stupidityisavirtue/ODT2026-The-Wanderer/Electronics Details/Circuit Diagrams/Manual Servo Circuit Diagram.jpeg

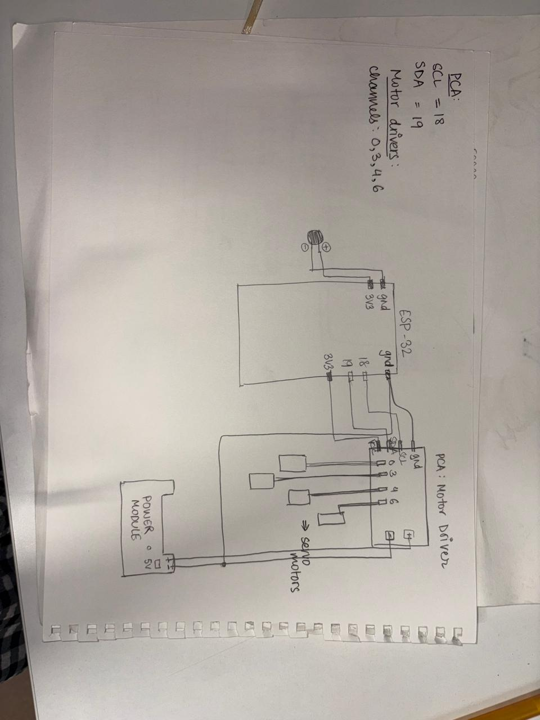
Electronics Details/Circuit Diagrams/Manual Servo Circuit Diagram.jpeg
