stupidityisavirtue/ODT2026-The-Wanderer/Electronics Details/Circuit Diagrams/Manual Console Diagram.jpeg

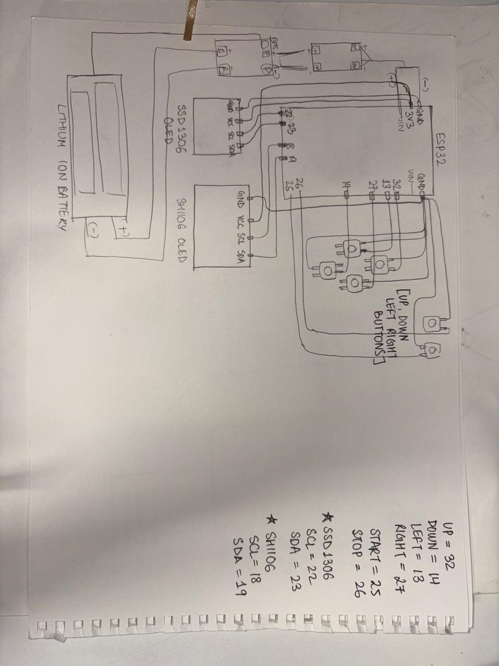
Electronics Details/Circuit Diagrams/Manual Console Diagram.jpeg
