stupidityisavirtue/ODT2026-The-Wanderer/Electronics Details/Electronic_Details_filled BY Manasa.docx

Electronics Documentation

Wanderer — A Dancing Doll Console Game

Manasa | Section C | 2025014044

# 1. Electronics Block Diagram

Wanderer consists of two physically separate ESP32 systems communicating wirelessly via ESP-NOW. The diagram below describes the signal and power flow across both units.

## Signal & Power Flow

- Console ESP32 → I2C0 (SCL=18, SDA=19) → SH1106 OLED (game display)
- Console ESP32 → I2C1 (SCL=22, SDA=23) → SSD1306 OLED (animation display)
- Console ESP32 → GPIO 27/14/32/13/25/26 → 6 tactile buttons (active-low, PULL_UP)
- Console ESP32 → ESP-NOW (Wi-Fi radio) → Stage ESP32 (UP/DOWN/LEFT/RIGHT commands)
- Stage ESP32 → I2C (addr 0x40) → PCA9685 PWM Driver
- PCA9685 → PWM channels 0, 3, 4, 6 → 4 Servo Motors (doll limbs)
- 18650 × 2 → 5V Power Module → Stage ESP32 + PCA9685 + Servos

## Console ESP32 — Pin Map

Component | Pin / Bus | Configuration
SH1106 OLED (game) | SCL = GPIO 18, SDA = GPIO 19 | I2C0
SSD1306 OLED (anim) | SCL = GPIO 22, SDA = GPIO 23 | I2C1
RIGHT button | GPIO 27 | PULL_UP, active low
DOWN button | GPIO 14 | PULL_UP, active low
UP button | GPIO 32 | PULL_UP, active low
LEFT button | GPIO 13 | PULL_UP, active low
START button | GPIO 25 | PULL_UP, active low
STOP button | GPIO 26 | PULL_UP, active low

## Stage ESP32 — Pin Map

Component | Channel / Pin | Notes
PCA9685 PWM Driver | I2C addr 0x40, SCL/SDA | Controls all 4 servos
Servo — UP (right arm) | PCA9685 Channel 0 | Neutral = 65°, duty range 500–1800µs
Servo — DOWN (right leg) | PCA9685 Channel 3 | Neutral = 65°, duty range 500–1800µs
Servo — LEFT (left arm) | PCA9685 Channel 4 | Neutral = 65°, duty range 500–1800µs
Servo — RIGHT (left leg) | PCA9685 Channel 6 | Neutral = 65°, duty range 500–1800µs
Power | 2× 18650 Li-ion cells | 5V output via power module

# 2. Components Table

The following table lists every component used in Wanderer, its quantity, purpose in the system, and justification for choosing it over alternatives.

Component | Qty | Purpose | Justification
ESP32 (Console) | 1 | Main microcontroller for the console unit | Dual-core, built-in Wi-Fi/ESP-NOW support, enough GPIOs for dual I2C buses and 6 buttons; runs MicroPython
ESP32 (Stage) | 1 | Receiver microcontroller on the doll stage | Same family ensures ESP-NOW compatibility; handles PCA9685 I2C and servo control independently
SH1106 OLED (128×64) | 1 | Primary game display — shows 4-lane rhythm game, scrolling arrows, score counters | I2C interface simplifies wiring; 128×64 resolution sufficient for 4-lane layout and text counters; low power
SSD1306 OLED (128×64) | 1 | Secondary animation display — shows character poses (idle/up/down/left/right/error) | Different I2C address from SH1106 allows both on same ESP32; same form factor; fast refresh for animation frames
PCA9685 PWM Driver | 1 | Controls 4 servo motors via I2C on the stage ESP32 | Offloads PWM generation from ESP32; 16-channel driver handles all 4 servos from a single I2C bus (addr 0x40); 12-bit resolution
Servo Motors (SG90 off-brand) | 4 | Physically move the doll's limbs (right arm, right leg, left arm, left leg) | Compact and lightweight for doll-scale linkages; sufficient torque; 4 channels map to UP/DOWN/LEFT/RIGHT commands
Push Buttons (6mm tactile) | 6 | User input — 4 directional (R/D/U/L) + START + STOP | Simple, reliable, widely available; active-low with internal pull-up resistors; debounced in software (200ms window)
18650 Li-ion Cells | 2 | Power supply for the stage unit (ESP32 + PCA9685 + 4 servos) | Sufficient capacity for sustained servo operation; 5V regulated output via power module; rechargeable and portable
Power Module (5V regulator) | 1 | Regulates 18650 output to stable 5V for stage electronics | Prevents voltage fluctuation from servo load spikes damaging the ESP32 or PCA9685
Pull-up Resistors (10kΩ) | 6 | Hardware pull-up for all 6 button GPIO pins on console ESP32 | Ensures defined logic level when button is open; reduces software debounce burden; prevents floating-pin noise
Breadboard + Jumper Wires | 1 set | Prototyping platform for console and stage wiring | Allowed rapid iteration during development; acknowledged as a reliability risk — identified for future PCB replacement

## Key Design Decisions

- Dual I2C buses: The SH1106 and SSD1306 OLEDs were placed on separate I2C instances (I2C0 and I2C1) to avoid address conflicts and allow independent refresh cycles.
- ESP-NOW over Bluetooth: ESP-NOW was chosen for its low latency (<100ms target), connectionless architecture, and native support on ESP32 without requiring a Wi-Fi router.
- PCA9685 for servo control: Offloading PWM generation to a dedicated 16-channel driver keeps the stage ESP32 free from timing-critical PWM loops and allows precise per-channel duty cycle calibration.
- Off-brand servo calibration: Standard 1000–2000µs duty cycle ranges did not work with the procured servos. Manual sweeping identified working ranges of 500–1800µs, which were hardcoded per channel.
- Breadboard construction: The console and stage were both prototyped on breadboards to allow rapid iteration. This introduced connection reliability issues during testing and is identified as the primary area for improvement in a future version (custom PCB).
