stupidityisavirtue/ODT2026-The-Wanderer/Project Documents/Planning_Management Manasa.docx

Project Planning & Management

Wanderer — A Dancing Doll Console Game

Manasa | Section C | 2025014044

# 1. Project Overview

Project Title: Wanderer — A Dancing Doll Console Game

Team Members & Roles: Manasa (lead — electronics, software, assembly), Arshia (code debugging, partial assembly), Aryan (materials & support logistics only)

Description: Wanderer is an interactive arcade-style installation built on two ESP32 microcontrollers. The player presses directional buttons on a custom console to match falling rhythm-game arrows on an OLED display, while a second OLED shows a character animation reacting to each input. Wirelessly, the console ESP32 sends commands via ESP-NOW to a stage ESP32 that physically moves a dancing doll using servo motors and a PCA9685 driver.

# 2. Team Roles & Responsibilities

Member Name | Role | Responsibilities
Manasa | Electronics, Software & Assembly | Assembled and soldered all circuits; designed console hardware layout; wrote and debugged base MicroPython code; independently developed the full OLED animation system; implemented start/stop state logic; explored ESP-NOW integration; built motion rig servo code; 3D printed console model; created doll DXF files; structural drilling and stage assembly; overall system integration
Arshia | Code & Assembly Support | Participated in collaborative debugging sessions on the base code and helped with the error and counter system; assisted with partial physical assembly of the stage, servo base code
Aryan | Materials & Support Logistics | Sourced and managed materials; handled logistical support tasks only — no code, circuit, or assembly contribution

# 3. Project Timeline & Milestones

Week | Goals | Deliverables | Status
Week 1 | Hardware setup, pin wiring, dual OLED init, button config, note generation logic | Both OLEDs responding; directional & start/stop buttons wired; generate_notes() function; basic lane + hit-line drawn on SH1106 | ✅ Complete
Week 2 | Core game loop, animation system, start/stop state machine, debounce logic, ESP-NOW sender code | Falling arrow notes rendering; character animation on SSD1306 reacting to inputs; working start/stop with nested-loop logic; ESP-NOW sender transmitting button commands | ⚠️ Mostly Complete — ESP-NOW receiver integration partial
Final | Servo integration, stage assembly, physical doll mounting, end-to-end testing, documentation | Stage laser cut; doll mounted with 4 servos; PCA9685 driver controlling limbs; full system test; all documentation submitted | ⚠️ Partial — servo-game integration incomplete; console & animation fully working

# 4. Weekly Progress Log

## Week 1

Planned Tasks:

- Set up I2C buses for SH1106 (game display) and SSD1306 (animation display)
- Configure 6 GPIO button pins (right = 27, down = 14, up = 32, left = 13, start = 25, stop = 26) with pull-up resistors
- Write generate_notes() to produce 50 timestamped notes assigned random lanes
- Draw the 4-lane layout and hit line (HIT_LINE_Y = 43) on the SH1106
- Import animation bitmap modules (idle, up, down, left, right, error)

Completed Tasks:

- Both I2C buses initialised and both OLEDs confirmed responding
- All 6 button pins wired and reading correctly
- generate_notes() producing valid note sequences
- Lane grid and hit line drawing confirmed on game display
- Animation module imports verified

Challenges Faced:

- SH1106 and SSD1306 share I2C but use different addresses — took time to confirm bus separation on I2C0 vs I2C1
- Off-brand pull-up resistors giving slightly noisy readings on some pins
- Initial animation framebuffer used wrong mode (MONO_HLSB vs MONO_VLSB) causing garbled output

Solutions:

- Used separate I2C instances (machine.I2C(0) and machine.I2C(1)) to isolate the two displays
- Added DEBOUNCE_MS = 200 constant and is_pressed() helper to filter noisy button reads
- Switched animation display to MONO_HLSB framebuffer format — output corrected

Next Steps:

- Build the active game loop with note scrolling and hit detection
- Implement start/stop state transitions
- Begin animation state machine tied to button presses

## Week 2

Planned Tasks:

- Complete game loop: note Y-position calculation, arrow drawing, hit/miss detection
- Implement animation state machine (idle / up / down / left / right / error)
- Build start/stop logic with debounce and nested while-True structure
- Write ESP-NOW sender code to transmit directional button commands wirelessly
- Test combo counter and error counter rendering on game display

Completed Tasks:

- Game loop fully working: notes scroll at correct speed (dist/30 formula), hit window ±250ms working
- Animation state machine complete — character reacts to every button press, returns to idle after 1 second of inactivity
- Start/stop state machine implemented using nested while-True with debounce — took ~1 full day of debugging
- ESP-NOW sender script written and tested: sends UP/DOWN/LEFT/RIGHT on button press, deduplicates held-button messages
- Combo (C:) and Error (E:) counters rendering correctly in the game display corner

Challenges Faced:

- Start/stop had NO break logic at first — the game had no way to enter or exit a running state properly
- ESP-NOW buttons were being read sequentially in a for loop, causing missed inputs when multiple buttons were held
- Loose breadboard wiring triggered ENODEV and I2C timeout errors that looked like software bugs — wasted hours
- Back-drove a circuit while testing — damaged a laptop
- Off-brand servos did not respond to standard duty cycle values — had to experimentally find correct PWM ranges

Solutions:

- Rewrote main loop with a 'running' boolean flag + nested while-True structure so start/stop cleanly transitions game state
- Replaced sequential button loop with simultaneous state snapshot: current = [not p.value() for p in pins]
- Re-seated all breadboard connections and added tape-over to unstable pins; confirmed hardware first before re-testing code
- Manually swept duty cycle values for off-brand servos and hardcoded the working ranges

Next Steps:

- Integrate ESP-NOW receiver with servo control on the stage ESP32
- Mount doll and servos inside the laser-cut stage box
- End-to-end test: button press → OLED animation → ESP-NOW → servo movement

## Final Week

Planned Tasks:

- Complete ESP-NOW receiver + PCA9685 servo control integration
- Mount doll inside laser-cut stage box with servo linkages
- Run full end-to-end system test (console → wireless → doll)
- Finalise all documentation

Completed Tasks:

- Stage fully laser cut from MDF — structural assembly complete
- Doll mounted on servo linkages inside the box — limbs moving on command
- PCA9685 motor driver controlling 4 servos (channels 0, 3, 4, 6), reset_all() to neutral at startup
- ESP-NOW receiver decoding UP/DOWN/LEFT/RIGHT commands and triggering brief servo movements (move → 0.3s → neutral)
- Console OLED game and animation running in full sync
- All documentation completed

Challenges Faced & Where We Fell Short:

- Clean integration of the ESP-NOW link WITH the live game loop was not fully achieved — servo movements worked standalone but not perfectly synced in real-time gameplay
- No audio feedback (buzzer/sound cues) was ever added — noted as a significant missing experience element by all testers
- Spent too much time early on aesthetics (stage decor) instead of locking in software integration first
- Wiring on breadboard remained fragile throughout — could not reliably transfer to a permanent PCB
- Servos work independently with esp now but not in main code (added videos)
