stupidityisavirtue/ODT2026-The-Wanderer/Software Details/Wanderer_Software_Documentation.docx

Wanderer

Software Documentation

A Dancing Doll Console Game

Manasa

# 1. Software Overview

## What does the software do?

Wanderer is an interactive arcade-style game running on MicroPython on an ESP32 microcontroller. The software drives two OLED displays simultaneously — one showing the rhythm game (falling directional arrows that the player must hit in time) and the other displaying a character animation that reacts to the player's inputs. The game tracks combos and errors, and wirelessly communicates with a second ESP32 via ESP-NOW to control servo motors that physically move a dancing doll on stage.

## Platforms Used

- MicroPython — core game logic, hardware control, and display rendering
- ESP32 Microcontroller (×2) — one for the console/game, one for the stage/servo control
- ESP-NOW (Wi-Fi protocol) — wireless communication between the two ESP32 units
- SH1106 OLED Display — renders the rhythm game arrows and lane layout
- SSD1306 OLED Display — renders the character animation frames
- PCA9685 PWM Controller — drives four servo motors for the doll's limb movements

# 2. System Logic

The system operates across four sequential stages:

## Stage 1 — Startup & Idle

- ESP32 initialises both OLED displays and all GPIO button pins with pull-up resistors
- The game display shows "PRESS START" and the animation display shows the idle character frame
- The system waits in a polling loop, checking for the START button with debounce logic

## Stage 2 — Game Start

- Player presses the START button
- All game variables reset (combo = 0, errors = 0)
- A sequence of 50 notes is generated, each assigned a random lane (up/down/left/right) and a timestamp
- A start timer begins — game loop enters active state

## Stage 3 — Active Game Loop

- Elapsed time is calculated continuously
- Arrow notes scroll downward toward a hit line based on their timestamp vs. current time
- Player presses the correct directional button (right/down/up/left)
- If the press is within ±250ms of the note's timestamp → HIT: combo increments, note marked as complete
- If the note passes the window without being pressed → MISS: error count increments, error animation plays
- The character animation on the second display reacts to each button press (up/down/left/right/error/idle)
- Button presses are sent wirelessly via ESP-NOW to the receiver ESP32 on stage
- The receiver ESP32 moves the corresponding servo motor and returns it to neutral after 0.3 seconds

## Stage 4 — Stop / Game End

- Player presses the STOP button at any time
- Both displays clear; "STOPPED" message shows briefly
- System returns to idle state, waiting for START again

# 3. Flowchart

The following represents the logical flow of the Wanderer software system:

1. Power On | ESP32 boots, displays initialise, buttons configured

2. Idle Screen | Shows 'PRESS START' on game display, idle animation plays

3. START pressed? | Polls START button with debounce (200ms threshold)

4. Game Initialisation | Reset scores, generate 50 random notes with timestamps

5. Game Loop Active | Calculate elapsed time, scroll notes toward hit line

6. Note reaches hit window? | If within ±250ms of note time → check for button press

7. Correct button pressed? | YES → HIT (combo++, note complete) / NO → MISS (error++)

8. Animate character | Display reacts: up/down/left/right/error/idle state

9. Send via ESP-NOW | Button press transmitted wirelessly to stage ESP32

10. Servo moves | Corresponding limb servo moves, returns to neutral after 0.3s

11. STOP pressed? | YES → clear displays, show 'STOPPED', return to idle

# 4. Hardware & Pin Reference

The following pin assignments are used on the console ESP32:

Component | Pin / Value | Notes
SH1106 OLED (game) | SCL: 18 / SDA: 19 | Rhythm game display
SSD1306 OLED (anim) | SCL: 22 / SDA: 23 | Character animation display
Right button | GPIO 27 | Directional input
Down button | GPIO 14 | Directional input
Up button | GPIO 32 | Directional input
Left button | GPIO 13 | Directional input
Start button | GPIO 25 | Game control
Stop button | GPIO 26 | Game control

# 5. Code Logic Explanation

## Block 1 — Hardware Setup & Configuration

This section imports all required libraries for GPIO, I2C, display rendering, timing, and random number generation, along with custom animation frame modules (idle, up, down, left, right, error). It configures both I2C buses for the two OLEDs and sets up six button pins (four directional, start, stop) as inputs with pull-up resistors. Key constants are defined: LANE_WIDTH (24px), HIT_LINE_Y (43px), GOOD_WINDOW (±250ms timing window), and DEBOUNCE_MS (200ms). A shared framebuffer is also prepared for the animation display.

## Block 2 — Note Generation, Debounce & Game State

The generate_notes() function creates 50 notes, each spaced 2 seconds apart from the game start, assigned a random lane (0–3). The is_pressed() helper prevents button bounce by requiring a minimum gap of DEBOUNCE_MS milliseconds between press registrations. The main() function initialises all game state variables and renders the idle screen, then enters a continuous loop handling start/stop inputs using the debounce system — stopping resets the display, starting regenerates notes and resets all counters.

## Block 3 — Main Game Loop & Input Handling

Each iteration of the loop calculates elapsed time, clears and redraws the OLED (4 lanes + hit line). Button states are compared with the previous frame to detect fresh presses (not held inputs). When a new press is detected, the animation state updates accordingly and the timestamp is recorded. Notes are iterated: their vertical Y position is calculated from their timing offset, and if within the visible range they are drawn as directional arrow glyphs. Hits within the GOOD_WINDOW increment the combo; notes that pass the window without being hit increment errors and trigger the error animation.

## Block 4 — ESP-NOW Sender (Console ESP32)

This script initialises Wi-Fi in station mode and activates ESP-NOW, registering the stage ESP32's MAC address as a peer. Four directional buttons are monitored in a continuous loop. When a button is pressed, a command string ("UP", "DOWN", "LEFT", or "RIGHT") is generated. The command is only transmitted if it differs from the last sent value, preventing repeated messages from held buttons. When no buttons are pressed, the last-sent state resets so the next press will transmit again.

## Block 5 — ESP-NOW Receiver & Servo Control (Stage ESP32)

The receiver ESP32 manages four servo motors through a PCA9685 PWM driver over I2C. A reset_all() function moves all servos to a neutral angle (65°) on startup. When an ESP-NOW message arrives, it is decoded and matched to a direction command. The corresponding servo briefly moves to a target angle, waits 0.3 seconds, and returns to neutral. This produces quick, momentary limb movements in sync with the player's console inputs.

# 6. Project Milestones

- Stage structure laser cut from MDF
- First cardboard prototype of the dancing doll fabricated and wired
- All four servo motors successfully connected through PCA9685 motor driver
- Complete circuit (ESP32 + OLEDs + buttons + battery) integrated inside the stage box
- Rhythm game and character animation running in sync on dual OLED displays
