stupidityisavirtue/ODT2026-The-Wanderer/Project Documents/Learning and Reflection Varanasi Manasa.docx

# Learnings & Reflections Document

Varanasi Manasa

Section C

2025014044

### 1. Team Reflection

- How did the team work together?

The team faced some notable coordination challenges throughout the project. Communication gaps arose fairly regularly, and there were moments where a lack of initiative from certain members created bottlenecks that slowed overall progress. Roles and responsibilities were not always clearly defined or followed through on, which led to confusion and some tasks being left unaddressed until the last minute. Despite these hurdles, the team ultimately pulled through and managed to deliver a working outcome. The experience highlighted how critical consistent communication and proactive ownership are in a collaborative project environment.

- What worked well?

Despite the coordination challenges, the team demonstrated real resilience in pushing through obstacles and finding solutions under pressure. The console component of the project worked very well and was a clear success. Collaborative debugging sessions particularly between team members working on the base code proved effective and helped resolve several complex software issues. The final visual output was something the team could genuinely be proud of, even if not everything matched the original vision.

- What could be improved? Communication and coordination could have been significantly more structured. Establishing clearer responsibilities and check-ins from the beginning would have reduced the number of complaints and misunderstandings along the way. On the technical side, better planning around wiring, circuit safety, and prototyping methodology would have saved considerable time. Additionally, having a more defined scope from the outset rather than trying to incorporate too many features simultaneously would have allowed the team(us) to execute more cleanly and achieve a more complete final result.

### 2. Technical Reflection

- Key technical challenges One of the earliest and most time-consuming challenges was getting the start/stop initialization to function correctly. The code initially had no break logic, so it did not know how to properly enter or exit a running state. Resolving this took nearly a full day of debugging. A second significant issue arose with the ESP-NOW communication code: the buttons were being read sequentially in a loop rather than simultaneously, which caused missed inputs and unreliable behavior. Beyond software, loose and poorly managed wiring turned out to be the root cause of many hardware errors common errors like ENODEV and connection timeouts that initially appeared to be code bugs were ultimately traced back to loose connections on the breadboard. Because prototypes could not be reliably translated to a more permanent form, everything had to remain on breadboard, which introduced its own fragility. Material challenges also arose, particularly with foamboard and servo torque. Off-brand servos presented an additional problem: they did not respond correctly to their specified duty cycles, requiring significant experimentation to find working values. A particularly damaging incident occurred when a circuit was inadvertently back-driven, resulting in damage to a laptop. While a wireless ESP-NOW connection was eventually established, integrating it cleanly with the game logic remained unresolved by the end of the project.
- What did you learn (hardware/software)? A major software lesson was understanding the importance of control flow structures specifically the use of break and continue statements, and the ability to nest a while True loop inside another loop to create interruptible states. This was a concept that had not been used before and turned out to be essential for the start/stop logic. On the hardware side, the project reinforced just how critical clean, reliable wiring is: a surprisingly large proportion of bugs that appeared to be software issues were actually caused by loose or incorrect physical connections. Library management was also a learning area, as installing and configuring the correct libraries for ESP32 and peripheral components required troubleshooting across multiple tools. Additionally, working with byte arrays manually rearranging them and importing them into the main codebase was a time-consuming but instructive process.
- Mistakes & debugging experiences A recurring mistake was debugging the code in isolation without running the servos simultaneously which made it very difficult to catch integration issues until late in the process. This delayed identifying problems that only appeared when multiple components were active at once. Indentation errors were a persistent source of frustration in the Python/MicroPython codebase, particularly given the volume of if/elif conditions used in the animation logic. Initialising certain components without properly declaring them as pins caused multiple setup failures early on. The decision to build the game logic first and integrate input controls afterward also proved to be a significant structural misstep by the time input handling needed to be added, the codebase had grown complex enough that rewriting or integrating cleanly was very difficult. Circuits were also not always checked for back-current risk, which led to the laptop damage incident.

### 3. Design Reflection

- Did the experience match your intention? Not entirely. The original concept was an animatronic lightbox with an integrated game console an ambitious and well-defined vision. While the console component functioned well, the broader vision was only partially realised. A lot of time that could have gone toward completing the experience was absorbed by debugging, reorganising byte arrays, and dealing with hardware failures. In hindsight, the team attempted to tackle too many complex systems at once without a clear prioritisation order, which led to the project scope outpacing the available time and resources. That said, the visual output that was achieved is something genuinely worth appreciating even if it did not fully match the original intent.
- What would you improve? The most important improvement would be to the development sequence: starting with input handling and building the game logic on top of that foundation, rather than the other way around. This would have made integration far smoother and avoided the “rabbit hole” of trying to retrofit input into an already complex codebase. On the hardware side, wiring practices need to be significantly more rigorous using proper connections and testing for back-current risk before powering circuits. Replacing the wireless ESP-NOW link with a wired connection between the two ESP32s would also improve reliability considerably. Adding audio-visual feedback (buzzers, LEDs) was something several people noted as missing this is an area that would greatly enhance the user experience and is worth prioritising in any future iteration. Additionally, being more deliberate about not over-investing in aesthetics early in the process, and instead locking in functionality first, would have led to a more complete and satisfying result.
- User feedback insights Feedback from others pointed to the absence of audio-visual feedback specifically buzzers and sound cues as a notable gap in the experience. This aligns with the team’s own reflection: an audio layer would have added a lot to the overall feel and interactivity of the project. The visual output was generally well received, which is encouraging given the challenges faced along the way. And giving a nice high score system although currently it function on permutations and combinations of counter and error to stop

### 4. Personal Reflection

Each member writes:

- What I learned One of the most important lessons from this project was to not prioritise aesthetics over functionality, especially in the early stages. A significant amount of time was spent on the physical assembly and stage design when that energy could have been directed toward stabilising the code. I also learned a great deal about control flow in MicroPython specifically, how to use break and continue effectively, and how nesting a while True loop inside another loop can create states that are both persistent and interruptible. Working extensively with byte arrays rearranging them manually and importing them into the main codebase was a new and challenging experience that taught me a lot about how data is structured and passed between components. On the hardware side, I now have a much deeper appreciation for how consequential loose or incorrect wiring can be: many errors that initially seemed like code problems turned out to be physical connection issues. I also learned the importance of testing all components simultaneously rather than in isolation, since integration bugs often only surface when the full system is running.
- What I struggled with Loose connections and unreliable hardware were a constant source of difficulty throughout the project, and dealing with those issues while simultaneously managing the codebase was mentally draining. The codebase itself grew difficult to navigate over time the volume of if/elif conditions in the animation code made it easy to lose track of logic flow, and indentation errors were a recurring frustration. Balancing time between working on the code and contributing to the physical assembly of the stage meant that neither area received the full focus it deserved. Not dedicating enough time purely to the code, particularly toward the end of the project, is something I genuinely regret and would approach differently if given another chance.
- What I am proud of I am genuinely proud of the animation code. Writing the full animation sequence from scratch with all its if/elif conditions and servo timing logic was a substantial piece of work and something I put real effort into. I also take pride in writing the base code and in the collaborative debugging process with Arshia that followed. Successfully implementing the start/stop initialization logic, including figuring out the nested loop structure that made it possible, was a real breakthrough moment in the project. Beyond the code, my contributions spanned a wide range of the project: assembling and soldering circuits, designing and building the console (including 3D printing the model), creating the doll’s base DXF files, working on the motion rig code, contributing to stage ideation and decor, drilling, and handling general physical assembly. Knowing that I played a central role in both the technical and physical dimensions of this project is something I feel good about, even with the challenges we faced along the way.

Personal Contribution

- Assembled the complete circuit setup, including wiring and soldering base circuits
- Designed and implemented the console circuitry and hardware layout
- Worked on stage construction, including drilling, structural setup, and physical assembly
- Contributed to stage ideation and overall visual design
- Built and 3D printed the console model
- Created DXF files for the doll’s base and assisted in fabrication
- Wrote and debugged base code collaboratively
- Independently developed the animation system for the OLED display
- Implemented start and stop initialization logic
- Explored and integrated ESP32 input handling and communication
- Contributed to motion rig control using servo-based logic
- Assisted in overall system integration, combining hardware and software components
