stupidityisavirtue/ODT2026-The-Wanderer/Mechanical Details/Source Files For All Mechnical Stuff/box.dxf

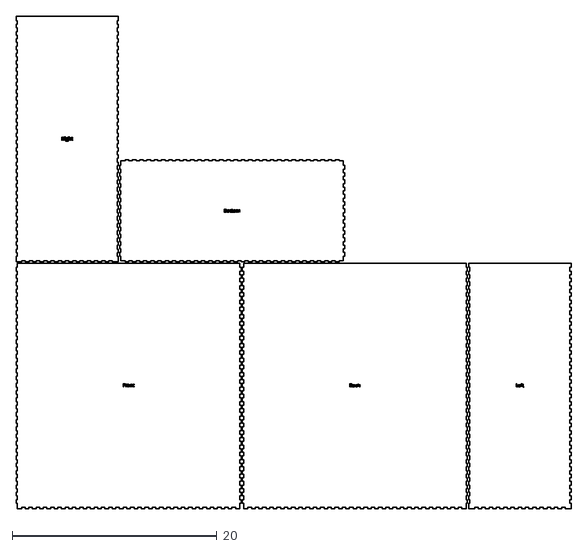
[picture p4: CAD file, 2026-04-22]
Mechanical Details/Source Files For All Mechnical Stuff/box.dxf
54.2 x 48.1
