stupidityisavirtue/ODT2026-The-Wanderer/Mechanical Details/Source Files For All Mechnical Stuff/Title Laser cut.dxf

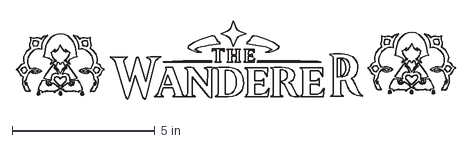
[picture p5: CAD file, 2026-04-22]
Mechanical Details/Source Files For All Mechnical Stuff/Title Laser cut.dxf
15.4 x 2.75 in
