stupidityisavirtue/ODT2026-The-Wanderer/Mechanical Details/Source Files For All Mechnical Stuff/UM2C_MONSTADT VISION FINAL.stl

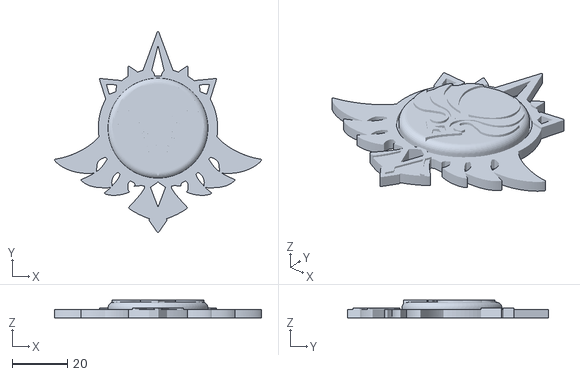
[picture p6: CAD file, 2026-04-22]
Mechanical Details/Source Files For All Mechnical Stuff/UM2C_MONSTADT VISION FINAL.stl
75.2 x 73.2 x 6.36
