stupidityisavirtue/ODT2026-The-Wanderer/Mechanical Details/Source Files For All Mechnical Stuff/Doll DXF FILE.dxf

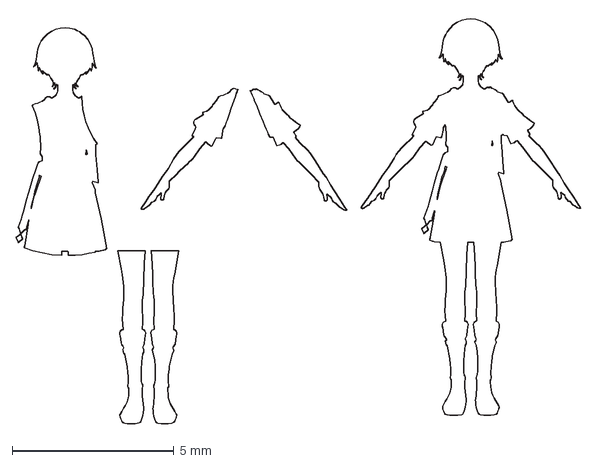
[picture p7: CAD file, 2026-04-22]
Mechanical Details/Source Files For All Mechnical Stuff/Doll DXF FILE.dxf
17.4 x 12.6 mm
