stupidityisavirtue/ODT2026-The-Wanderer/Mechanical Details/Source Files For All Mechnical Stuff/Console Final Final.3mf

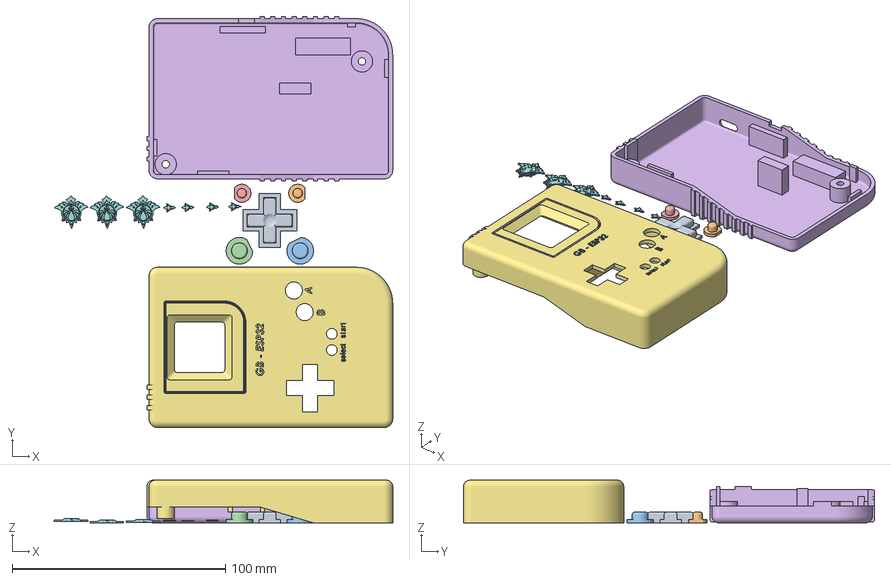
[picture p8: CAD file, 2026-04-21]
Mechanical Details/Source Files For All Mechnical Stuff/Console Final Final.3mf
158.6 x 192.6 x 20.0 mm
cross.STL
select.STL
a.STL
b.STL
start.STL
bottom casing.STL
top casing.STL
UGHHH BUTTONS ACCESORIESkhiuuighiuihuiuiu.stl
