stupidityisavirtue/ODT2026-The-Wanderer/Mechanical Details/Source Files For All Mechnical Stuff/UM2C_Scaramouche's HATTTT.3mf

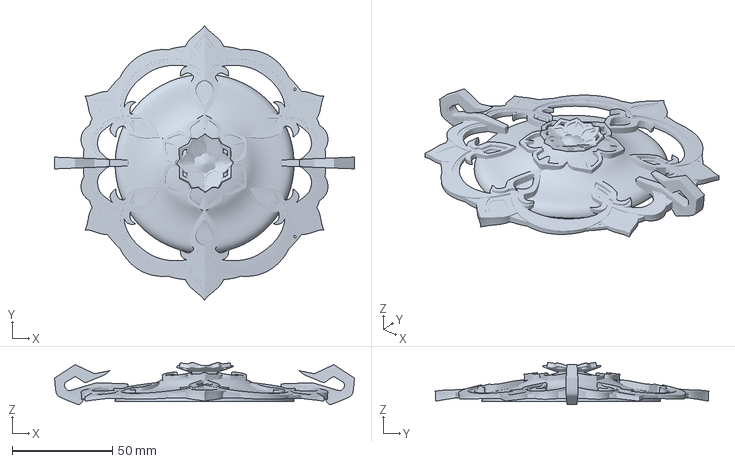
[picture p9: CAD file, 2026-04-21]
Mechanical Details/Source Files For All Mechnical Stuff/UM2C_Scaramouche's HATTTT.3mf
149.7 x 136.6 x 21.1 mm
