stupidityisavirtue/ODT2026-The-Wanderer/Project Documents/Test_Plan_Results Manasa.docx

Test Plan & Results

Wanderer — A Dancing Doll Console Game

Manasa | Section C | 2025014044

# 1. Test Plan

The following tests were planned across hardware responsiveness, game logic correctness, display rendering, wireless communication, and overall user experience.

Test | Method | Expected Result
Button debounce & responsiveness | Press each of the 6 buttons (right/down/up/left/start/stop) rapidly in succession; check if single press registers as one event | Each press registers exactly once; no double-triggers; is_pressed() blocks re-registration within 200ms
Note timing & hit window (±250ms) | Watch notes scroll to hit line; press the correct directional button at different offsets (early, on time, late, very late) | Presses within ±250ms mark note as HIT and increment combo; presses outside window register as MISS and increment errors
OLED game display rendering | Run the game loop and visually inspect the SH1106 display for correct lane lines, hit line at y=43, scrolling arrows, and score counters | 4 vertical lanes, 1 horizontal hit line, directional arrow glyphs scrolling correctly, C: and E: counters updating in real time
OLED animation display | Press each directional button and observe the SSD1306; wait 1 second without pressing anything | Correct animation frame (up/down/left/right) shown immediately on press; reverts to idle frame after ~1 second of inactivity
Start/stop state machine | Press START and confirm game begins; press STOP mid-game and confirm it halts; press START again to confirm restart | START enters running state, resets score and regenerates notes; STOP cleanly halts and clears display; re-START works without reboot
ESP-NOW wireless transmission | Flash sender code on console ESP32 and receiver code on stage ESP32; press each directional button; check receiver serial output | Receiver prints correct command (UP/DOWN/LEFT/RIGHT) matching the button pressed; held button does not spam repeated messages
Servo movement via PCA9685 | Trigger UP/DOWN/LEFT/RIGHT commands on receiver ESP32; observe each servo on the doll stage | Corresponding servo moves to target angle, holds for 0.3s, returns to neutral (65°); no jitter or stalling
Off-brand servo duty cycle calibration | Sweep PWM duty cycle values from low to high on each servo channel and record the values that produce correct 0° and 180° movement | Each servo responds to a consistent minimum and maximum duty cycle with full range of motion without stalling
Full end-to-end integration | Run the complete system: console game active, player pressing buttons, both OLEDs showing, ESP-NOW transmitting, servos on stage moving | Button press simultaneously triggers: correct arrow hit in game + animation on second OLED + servo movement on stage doll
Usability — first-time player | Hand the console to someone who has never seen the game; observe without instruction; note confusion points and time to first successful hit | Player understands directional input within ~30 seconds; can make at least 3 correct hits in the first 50-note sequence

# 2. User Testing

## Who were the users?

- 3–4 classmates from ODT class who had no prior knowledge of the Wanderer project
- 1 faculty reviewer during the final demonstration
- Testing was informal — each tester was handed the console without instructions to simulate a cold first-use experience

## What tasks were given?

- Press the START button and try to play the game (match the arrows)
- Try pressing STOP and then START again
- Play for a full 50-note sequence and observe the score
- Give verbal feedback on what felt missing or confusing

# 3. Results

Test | Outcome | Pass / Fail
Button debounce & responsiveness | Debounce worked correctly after is_pressed() helper was implemented. Prior to that, rapid presses were registering 2–3 times per press. | ✅ Pass
Note timing & hit window | Hit window of ±250ms felt slightly too generous at slow note speed but worked reliably. Late presses near the boundary were correctly classified as MISS. | ✅ Pass
OLED game display rendering | All 4 lanes, hit line, scrolling arrows, and score counters rendered correctly and updated in real time at 5ms loop delay. | ✅ Pass
OLED animation display | All 6 animation states (idle/up/down/left/right/error) displayed correctly. 1-second idle return worked as expected. | ✅ Pass
Start/stop state machine | START and STOP worked cleanly after the nested while-True logic was implemented. Previously, the game would not enter a running state at all due to missing break logic — this took ~1 full day to debug. | ✅ Pass (after major debug)
ESP-NOW wireless transmission | Sender script correctly transmitted button commands. Receiver decoded commands and printed correct direction strings. Held-button deduplication worked. | ✅ Pass (standalone)
Servo movement via PCA9685 | All 4 servos moved correctly once duty cycle values were calibrated per-servo. Off-brand units required significantly different values from the spec. | ✅ Pass (after calibration)
Off-brand servo duty cycle calibration | Standard duty cycles (1000–2000µs pulse) produced no movement or stalling on all 4 off-brand servos. Manual sweeping found working ranges between 500–1800µs depending on the unit. | ⚠️ Partial Pass — calibration resolved it but was not reliable across servo units
Full end-to-end integration | Console game and dual-OLED animation worked together fully. ESP-NOW transmission worked standalone. However, clean real-time integration of wireless + servo inside the active game loop was not fully achieved by submission. | ❌ Fail — partial integration only
Usability — first-time player | Most testers figured out the directional mapping within ~30 seconds. All noted the complete absence of audio feedback (no buzzer, no sound) as a significant gap that made the game feel incomplete. | ⚠️ Partial Pass — playable but missing audio layer

# 4. Observations

## User Behaviour

- Most testers immediately tried to press all buttons simultaneously on first contact — the debounce system handled this correctly
- The dual-OLED setup (game on one screen, animation character on the other) was well-received — testers found it visually engaging
- Several testers looked around for a speaker or buzzer instinctively, expecting audio feedback when arrows were hit or missed
- The STOP and START buttons were occasionally confused — placement on the console was not immediately intuitive without labels
- Testers who played for the full 50-note run commented that a high-score screen at the end would make the game feel more complete

## Pain Points

- Complete absence of audio feedback — the single most consistent complaint from every tester
- No visual 'perfect hit' or 'miss' flash on the game OLED — testers couldn't always tell if a press registered
- Breadboard wiring occasionally caused system resets mid-game — not reproducible but happened during testing sessions
- No game-end screen or score summary — the game just ran out of notes and went quiet
- Arrow glyphs at 8×8 pixels were small on the display — some testers found them hard to distinguish at first glance

# 5. Improvements Suggested

- Add a buzzer and sound cues — a short beep for a hit, a different tone for a miss — this was the highest-priority feedback from every tester
- Add a brief visual flash on the game display for hit confirmation (e.g., invert the lane briefly on successful press)
- Add a game-end summary screen showing final combo count, errors, and a score or grade
- Label or colour-code the START and STOP buttons on the console casing to reduce confusion
- Transition wiring from breadboard to a permanent soldered connection or custom PCB for reliability
- Replace the ESP-NOW wireless link with a wired UART connection between the two ESP32s for lower latency and higher reliability
- Increase arrow glyph size if display resolution allows, or add a small directional label below each lane
- Add a difficulty selector (slow / medium / fast note spawn rate) accessible from the idle screen
