stupidityisavirtue/ODT2026-The-Wanderer/Software Details/Week 02/Start test code.py

import machine #og
import time #og
import random #og
import framebuf #og
import sh1106 #og
import ssd1306
#animation codes
import idle
import up
import down
import left
import right
import error

# mewmewstart 
start_anim_data = bytearray([
    0x00, 0x00, 0x00, 0x00, 0x00, 0x00, 0x00, 0x00, 0x00, 0x00, 0x00, 0x00, 0x00, 0x00, 0x00, 0x00,
    0x00, 0x00, 0x00, 0x00, 0x00, 0x00, 0x00, 0x00, 0x00, 0x00, 0x00, 0x00, 0x00, 0x00, 0x00, 0x00,
    0x00, 0x00, 0x00, 0x00, 0x00, 0x00, 0x00, 0x00, 0x00, 0x00, 0x00, 0x00, 0x00, 0x00, 0x00, 0x00,
    0x00, 0x00, 0x00, 0x00, 0x00, 0x00, 0x00, 0x00, 0x00, 0x00, 0x00, 0x00, 0x00, 0x00, 0x00, 0x00,
    0x00, 0x00, 0x00, 0x00, 0x00, 0x00, 0x00, 0x00, 0x00, 0x00, 0x00, 0x00, 0x00, 0x00, 0x00, 0x00,
    0x00, 0x00, 0x00, 0x00, 0x00, 0x00, 0x00, 0x00, 0x00, 0x00, 0x00, 0x00, 0x00, 0x00, 0x00, 0x00,
    0x00, 0x00, 0x00, 0x00, 0x00, 0x00, 0x00, 0x00, 0x00, 0x00, 0x00, 0x00, 0x00, 0x00, 0x00, 0x00,
    0x00, 0x00, 0x00, 0x00, 0x00, 0x00, 0x00, 0x00, 0x00, 0x00, 0x00, 0x00, 0x00, 0x00, 0x00, 0x00,
    0x00, 0x00, 0x00, 0x00, 0x00, 0x00, 0x00, 0x00, 0x00, 0x00, 0x00, 0x00, 0x00, 0x00, 0x00, 0x00,
    0x00, 0x00, 0x00, 0x00, 0x00, 0x00, 0x00, 0x00, 0x00, 0x00, 0x00, 0x00, 0x00, 0x00, 0x00, 0x00,
    0x00, 0x00, 0x00, 0x00, 0x00, 0x00, 0x00, 0x00, 0x00, 0x00, 0x00, 0x00, 0x00, 0x00, 0x00, 0x00,
    0x00, 0x00, 0x00, 0x00, 0x00, 0x00, 0x80, 0x80, 0xC0, 0xC0, 0xE0, 0x60, 0x60, 0x60, 0x60, 0x60,
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
right_button = 12 #og
down_button   = 14 #og
up_button     = 32 #og
left_button   = 27 #og

# mewmewstart - Start and Stop Button Pins
START_BUTTON_PIN = 34 # mewmewstart
STOP_BUTTON_PIN  = 35 # mewmewstart

LANE_WIDTH = 24 #og
HIT_LINE_Y = 43 #og
GOOD_WINDOW = 250 #og



# Initialize I2C 0 for the SH1106 Game Display
i2c0 = machine.I2C(0, scl=machine.Pin(SCL_PIN), sda=machine.Pin(SDA_PIN), freq=400000) #og
display = sh1106.SH1106_I2C(128, 64, i2c0) #og

# Initialize I2C 1 for the SSD1306 Animation Display
i2c1 = machine.I2C(1, scl=machine.Pin(SSD1306_SCL), sda=machine.Pin(SSD1306_SDA), freq=400000)
anim_display = ssd1306.SSD1306_I2C(128, 64, i2c1)


anim_buffer = bytearray(128 * 64 // 8) 
anim_fb = framebuf.FrameBuffer(anim_buffer, 128, 64, framebuf.MONO_VLSB)

def update_ssd1306_animation(state, custom_data=None):
    """Selects the correct bytearray and updates the SSD1306 display."""
    # mewmewstart - Use custom_data if provided (for start/stop screens)
    if custom_data:
        data = custom_data
        # mewmewstart - custom_data is now expected to be in MONO_VLSB format
        temp_fb = framebuf.FrameBuffer(data, 128, 64, framebuf.MONO_VLSB)
    elif state == "up":
        temp_fb = framebuf.FrameBuffer(up.bitmap_data, 128, 64, framebuf.MONO_HLSB)
    elif state == "down":
        temp_fb = framebuf.FrameBuffer(down.bitmap_data, 128, 64, framebuf.MONO_HLSB)
    elif state == "left":
        temp_fb = framebuf.FrameBuffer(left.bitmap_data, 128, 64, framebuf.MONO_HLSB)
    elif state == "right":
        temp_fb = framebuf.FrameBuffer(right.bitmap_data, 128, 64, framebuf.MONO_HLSB)
    elif state == "error":
        temp_fb = framebuf.FrameBuffer(error.bitmap_data, 128, 64, framebuf.MONO_HLSB)
    else:
        temp_fb = framebuf.FrameBuffer(idle.bitmap_data, 128, 64, framebuf.MONO_HLSB)
    
    # Blit the data into the VLSB buffer
    anim_fb.fill(0)
    anim_fb.blit(temp_fb, 0, 0)
    anim_display.show() # anim_display.buffer is already linked to anim_buffer via anim_fb

# Initialize button pins with internal PULL_UP
pins = [
    machine.Pin(right_button, machine.Pin.IN, machine.Pin.PULL_UP), #og
    machine.Pin(down_button,   machine.Pin.IN, machine.Pin.PULL_UP), #og
    machine.Pin(up_button,     machine.Pin.IN, machine.Pin.PULL_UP), #og
    machine.Pin(left_button,   machine.Pin.IN, machine.Pin.PULL_UP)  #og
]

# mewmewstart - Initialize Start and Stop button pins
start_button = machine.Pin(START_BUTTON_PIN, machine.Pin.IN, machine.Pin.PULL_UP) # mewmewstart
stop_button  = machine.Pin(STOP_BUTTON_PIN,  machine.Pin.IN, machine.Pin.PULL_UP) # mewmewstart

# --- Arrow Bitmaps for SH1106 ---
arrow_left = bytearray([0x18,0x3C,0x7E,0x18,0x18,0x18,0x00,0x00]) #og
arrow_right = bytearray([0x18,0x18,0x18,0x7E,0x3C,0x18,0x00,0x00]) #og
arrow_up = bytearray([0x10,0x18,0x1C,0xFE,0x1C,0x18,0x10,0x00]) #og
arrow_down = bytearray([0x08,0x18,0x38,0xFE,0x38,0x18,0x08,0x00]) #og

def draw_arrow_direction(x, y, direction):
    """Draws the small arrows on the SH1106 game lanes."""
    if direction == "up": #og
        fb = framebuf.FrameBuffer(arrow_up, 8, 8, framebuf.MONO_VLSB) #og
    elif direction == "down": #og
        fb = framebuf.FrameBuffer(arrow_down, 8, 8, framebuf.MONO_VLSB) #og
    elif direction == "left": #og
        fb = framebuf.FrameBuffer(arrow_left, 8, 8, framebuf.MONO_VLSB) #og
    else: #og
        fb = framebuf.FrameBuffer(arrow_right, 8, 8, framebuf.MONO_VLSB) #og
    display.blit(fb, x-4, y-4) #og

# --- Game State ---
combo = 0 #og
errors = 0 #og
last_hit_time = 0 #og
animation_frame = 0 #og
pet_state = "idle" #og
last_btn_states = [False, False, False, False] #og

# mewmewstart - Game States
GAME_STATE_START_SCREEN = 0 # mewmewstart
GAME_STATE_PLAYING      = 1 # mewmewstart
GAME_STATE_STOP_SCREEN  = 2 # mewmewstart

current_game_state = GAME_STATE_START_SCREEN # mewmewstart

# mewmewstart - Function to generate notes (can be called multiple times for new games)
def generate_notes(): # mewmewstart
    global notes # mewmewstart
    notes = [] #og
    current_note_time = 2000 #og
    for i in range(50): #og
        current_note_time += 2000 #og
        notes.append({ #og
            "time": current_note_time, #og
            "lane": random.randint(0, 3), #og
            "hit": False, #og
            "passed": False #og
        }) #og

# --- Main Game Loop ---
def main():
    global combo, errors, pet_state, animation_frame, last_hit_time, last_btn_states, current_game_state

    # mewmewstart - Initial setup for displays
    display.fill(0)
    display.show()
    anim_display.fill(0)
    anim_display.show()

    current_anim_state = "idle"
    # update_ssd1306_animation("idle") # og - Removed to prevent initial frame flash

    while True:
        if current_game_state == GAME_STATE_START_SCREEN: # mewmewstart
            # mewmewstart - Start Screen Logic
            display.fill(0)
            display.text("Rhythm Game!", 10, 10, 1)
            display.text("Press START", 10, 30, 1)
            display.text("Pin 34", 10, 40, 1)
            display.show()

            update_ssd1306_animation("start_screen", custom_data=start_anim_data) # mewmewstart

            if not start_button.value(): # Button is pressed (active low) # mewmewstart
                # Reset game variables for a new game # mewmewstart
                combo = 0 # mewmewstart
                errors = 0 # mewmewstart
                last_hit_time = 0 # mewmewstart
                pet_state = "idle" # mewmewstart
                last_btn_states = [False, False, False, False] # mewmewstart
                generate_notes() # mewmewstart
                current_game_state = GAME_STATE_PLAYING # mewmewstart
                time.sleep_ms(200) # Debounce # mewmewstart

        elif current_game_state == GAME_STATE_PLAYING: # mewmewstart
            # og - Original game loop logic starts here
            start_time = time.ticks_ms() #og
            display.fill(0) #og
            current_time = time.ticks_diff(time.ticks_ms(), start_time) #og

            # Draw Lanes on SH1106
            for i in range(5): #og
                display.vline(i * LANE_WIDTH, 0, 64, 1) #og
            display.hline(0, HIT_LINE_Y, LANE_WIDTH * 4, 1) #og

            # --- Input Detection (Edge Detection) ---
            current_btn_states = [not p.value() for p in pins] #og
            btn_pressed = [False, False, False, False] #og
            for i in range(4): #og
                if current_btn_states[i] and not last_btn_states[i]: #og
                    btn_pressed[i] = True #og
            last_btn_states = current_btn_states #og

            # mewmewstart - Check for Stop button press during playing state
            if not stop_button.value(): # mewmewstart
                current_game_state = GAME_STATE_STOP_SCREEN # mewmewstart
                time.sleep_ms(200) # Debounce # mewmewstart
                continue # Skip the rest of the game logic for this frame # mewmewstart

            # --- Process Notes and Hit Detection ---
            for note in notes: #og
                if not note["hit"] and not note["passed"]: #og
                    dist = note["time"] - current_time #og
                    y = int(HIT_LINE_Y - (dist / 30)) #og
                    lane = note["lane"] #og
                    direction = ["right", "down", "up", "left"][lane] #og

                    if -10 < y < 64: #og
                        lane_x = lane * LANE_WIDTH + (LANE_WIDTH // 2) #og
                        draw_arrow_direction(lane_x, y, direction) #og

                    # Hit Detection Logic
                    if abs(dist) < GOOD_WINDOW: #og
                        if btn_pressed[lane]: #og
                            print("NICE - {} HIT".format(direction.upper())) #og
                            note["hit"] = True #og
                            combo += 1 #og
                            pet_state = direction # Trigger direction animation
                            last_hit_time = current_time #og
                            btn_pressed[lane] = False #og
                    
                    # Miss Detection Logic
                    elif dist < -GOOD_WINDOW: #og
                        note["passed"] = True #og
                        errors += 1 #og
                        print("ERROR: {} MISSED".format(direction.upper())) #og
                        pet_state = "error" # Trigger error animation
                        last_hit_time = current_time #og

            # --- Wrong Button Detection ---
            if any(btn_pressed): #og
                for i in range(4): #og
                    if btn_pressed[i]: #og
                        print("WRONG BUTTON PRESSED: Lane {}".format(i)) #og
                pet_state = "error" # Trigger error animation
                last_hit_time = current_time #og

            # Reset pet to idle after 500ms
            if time.ticks_diff(current_time, last_hit_time) > 500: #og
                pet_state = "idle" #og

            # --- SSD1306 Animation Update ---
            # Only update the second OLED if the state has changed to keep game smooth
            if pet_state != current_anim_state:
                update_ssd1306_animation(pet_state)
                current_anim_state = pet_state

            # --- UI Text on SH1106 ---
            display.text("E:{}".format(errors), 98, 30, 1) #og
            display.text("C:{}".format(combo), 98, 50, 1) #og

            display.show() #og
            time.sleep_ms(5) #og
            # og - Original game loop logic ends here

        elif current_game_state == GAME_STATE_STOP_SCREEN: # mewmewstart
            # mewmewstart - Stop Screen Logic
            display.fill(0)
            display.text("Game Over!", 10, 10, 1)
            display.text("Score: {}".format(combo), 10, 30, 1)
            display.text("Errors: {}".format(errors), 10, 40, 1)
            display.text("Press START to play again", 10, 55, 1)
            display.show()

            update_ssd1306_animation("stop_screen", custom_data=stop_anim_data) # mewmewstart

            if not start_button.value(): # mewmewstart
                current_game_state = GAME_STATE_START_SCREEN # mewmewstart
                time.sleep_ms(200) # Debounce # mewmewstart

        time.sleep_ms(10) # mewmewstart -

if __name__ == "__main__":
    # mewmewstart
    generate_notes()
    main() #og
