stupidityisavirtue/ODT2026-The-Wanderer/(commit log)

2026-04-22 Rename Software Details/Working Final Week 1 Code With Expression Meter (Too Fast Check).py to Software Details/Week 1/Working Final Week 1 Code With Expression Meter (Too Fast Check).py
    [Working Final Week 1 Code With Expression Meter (Too Fast Check).py]
2026-04-22 Update Servo Dance Reciever Movement.py
